ardyrobot/3d-print-ring-camera/docs/sketch.webp

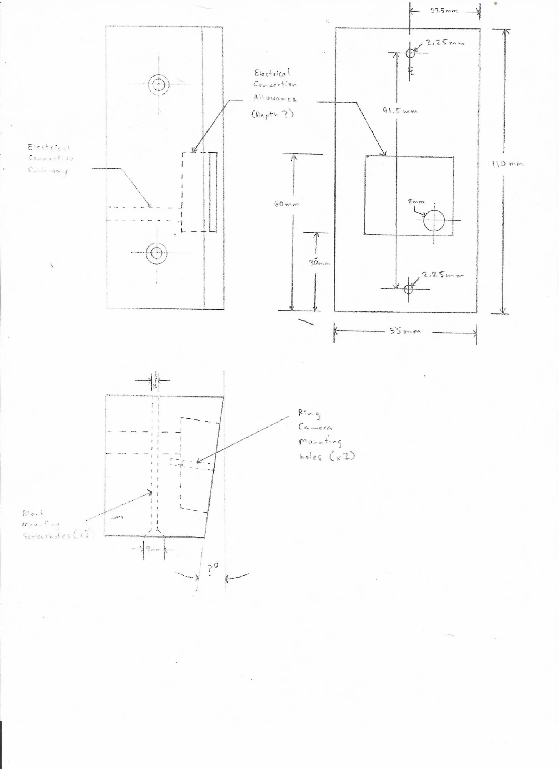
docs/sketch.webp
