ardyrobot/3d-print-ring-camera/option1-solid/docs/block-bottom.png

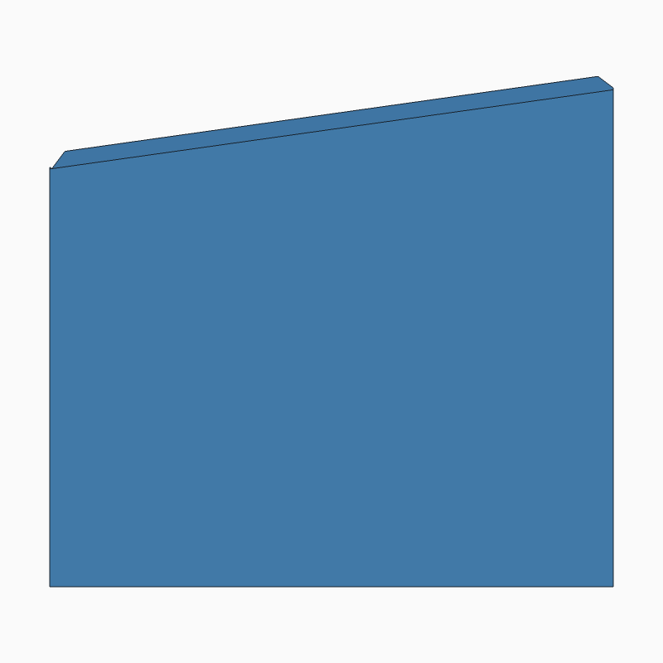
option1-solid/docs/block-bottom.png
