ardyrobot/3d-print-ring-camera/option4-pivot/stl/assembly_3.stl

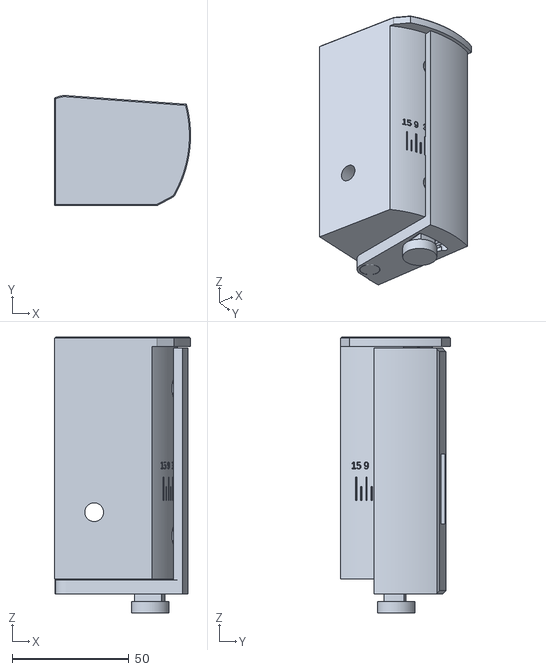
[picture p18: CAD file, 2026-11-03]
option4-pivot/stl/assembly_3.stl
58.3 x 47.2 x 118.1
