ardyrobot/3d-print-ring-camera/option2-hinge/stl/assembly_15.stl

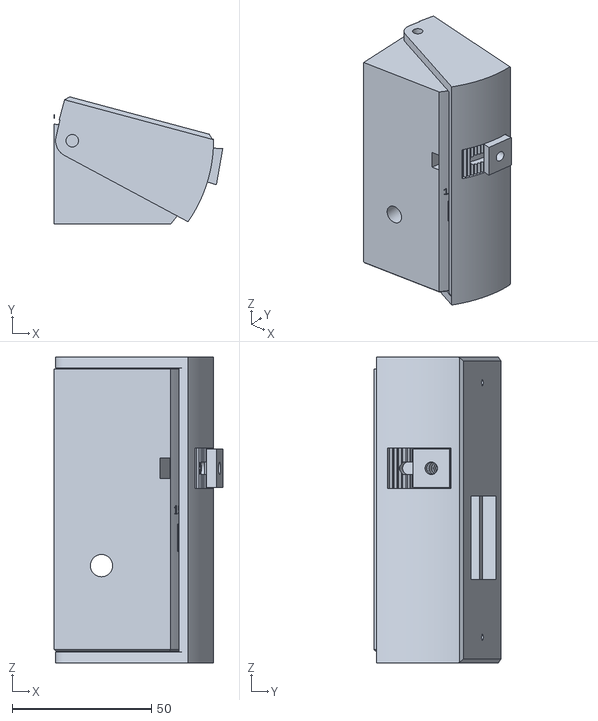
[picture p19: CAD file, 2026-11-03]
option2-hinge/stl/assembly_15.stl
60.6 x 45.8 x 110.0
