ardyrobot/3d-print-ring-camera/option2-hinge/stl/assembly_3.stl

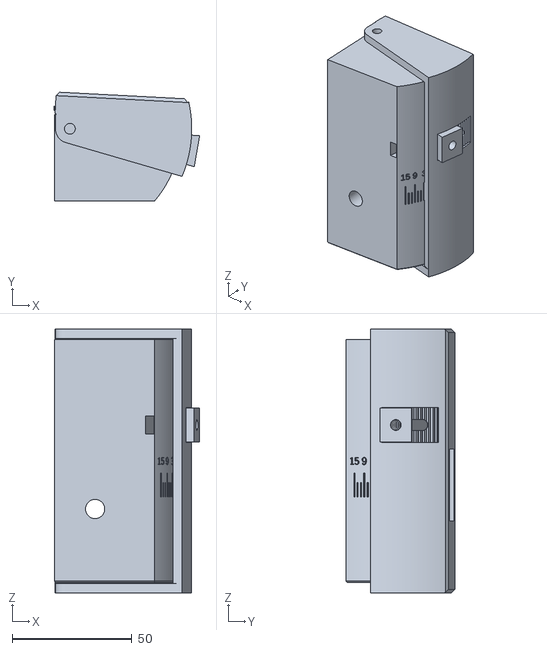
[picture p20: CAD file, 2026-11-03]
option2-hinge/stl/assembly_3.stl
60.6 x 45.2 x 110.0
