ardyrobot/3d-print-ring-camera/option3-dovetail/stl/assembly_3.stl

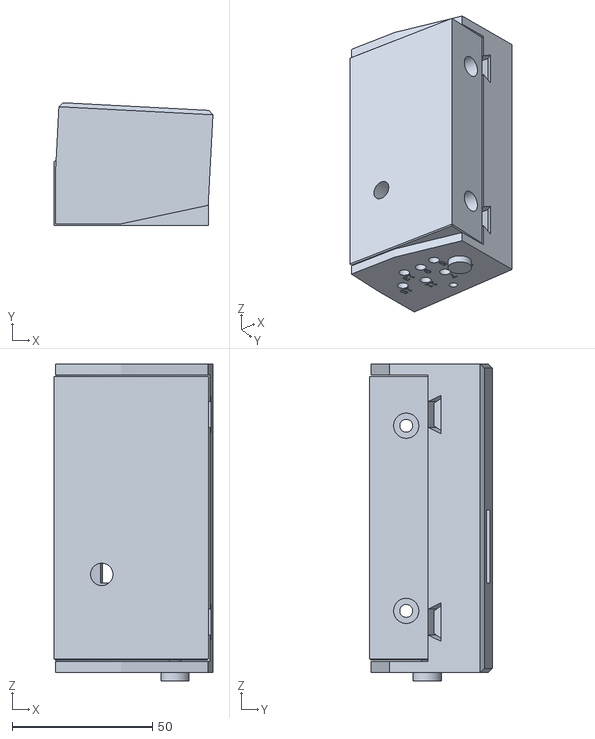
[picture p21: CAD file, 2026-11-02]
option3-dovetail/stl/assembly_3.stl
56.6 x 43.7 x 113.0
