ardyrobot/3d-print-ring-camera/option3-dovetail/stl/assembly_15.stl

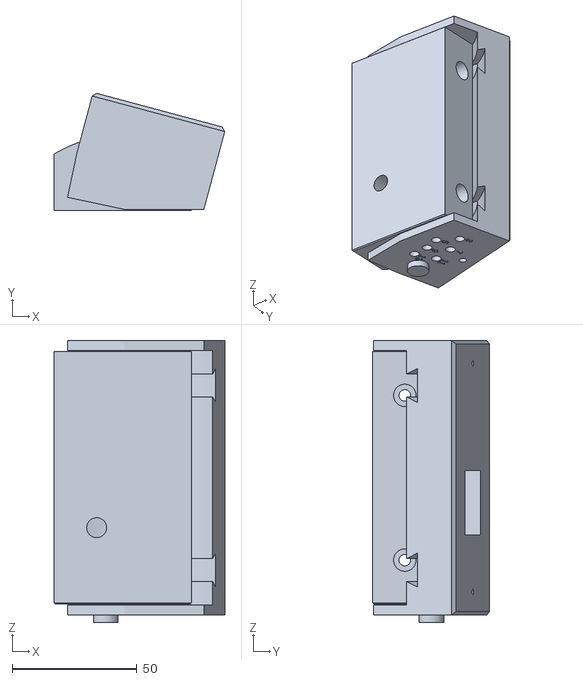
[picture p22: CAD file, 2026-11-02]
option3-dovetail/stl/assembly_15.stl
68.3 x 47.0 x 113.0
