ardyrobot/3d-print-ring-camera/option1-solid/stl/block.stl

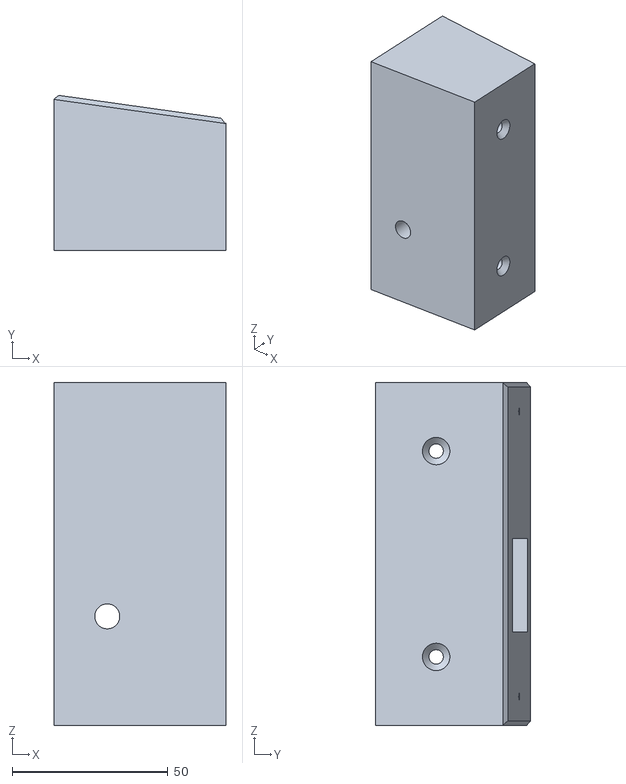
[picture p23: CAD file, 2026-11-03]
option1-solid/stl/block.stl
55.0 x 49.8 x 110.0
