ardyrobot/3d-print-ring-camera/option2-hinge/stl/shell.stl

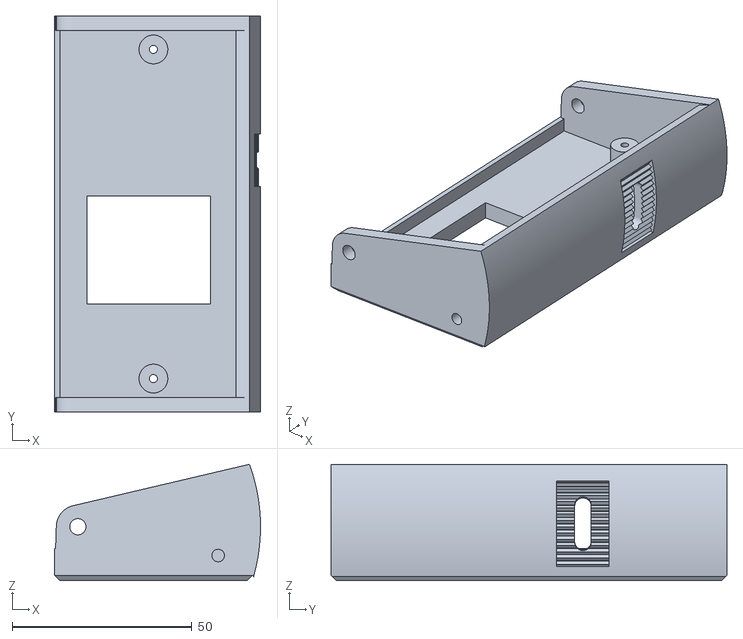
[picture p24: CAD file, 2026-11-03]
option2-hinge/stl/shell.stl
57.3 x 110.0 x 32.4
