ardyrobot/3d-print-ring-camera/option3-dovetail/stl/base.stl

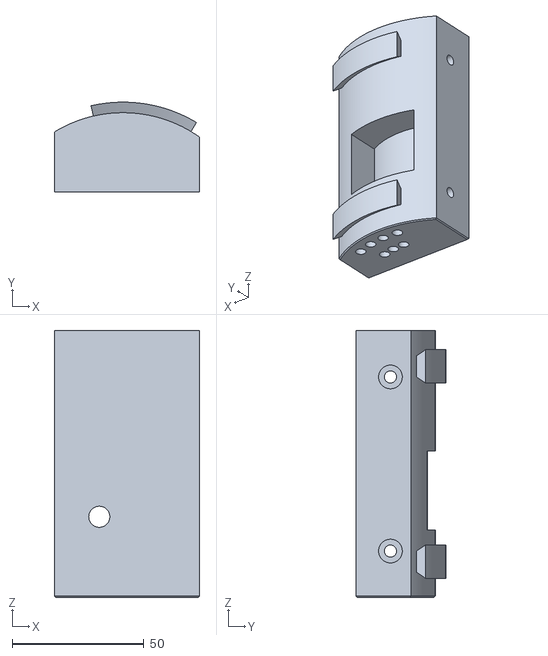
[picture p25: CAD file, 2026-11-02]
option3-dovetail/stl/base.stl
55.0 x 34.0 x 101.2
