ardyrobot/3d-print-ring-camera/option3-dovetail/stl/fit_test.stl

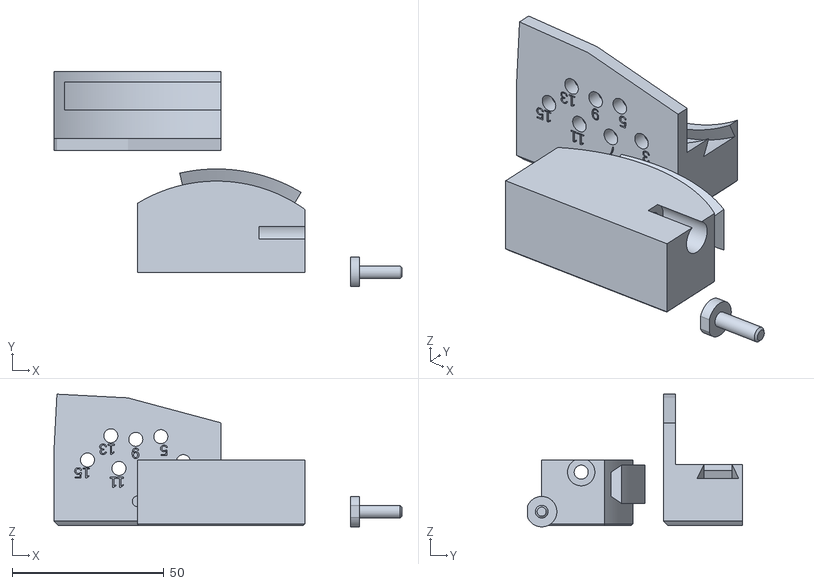
[picture p26: CAD file, 2026-11-02]
option3-dovetail/stl/fit_test.stl
114.5 x 70.6 x 43.7
