ardyrobot/3d-print-ring-camera/option4-pivot/stl/shell.stl

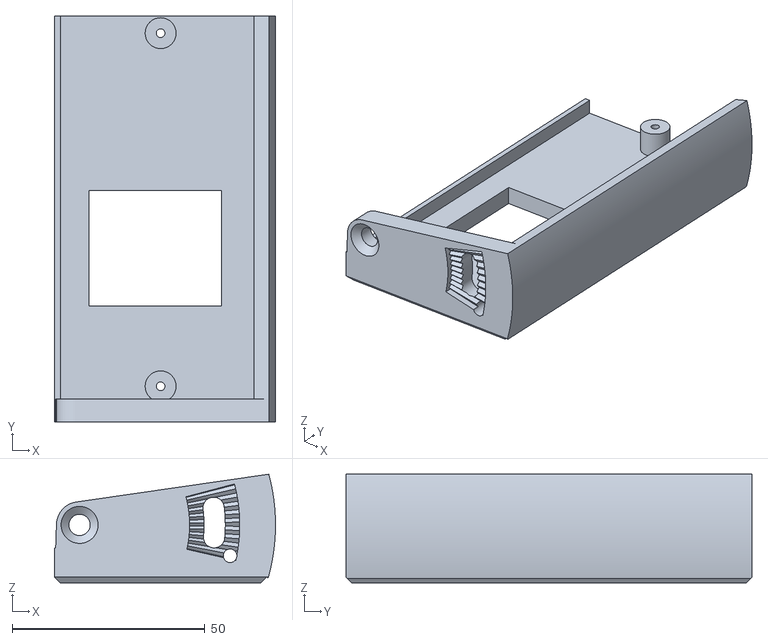
[picture p27: CAD file, 2026-11-03]
option4-pivot/stl/shell.stl
57.3 x 105.2 x 28.1
