ardyrobot/3d-print-ring-camera/option2-hinge/stl/fit_test.stl

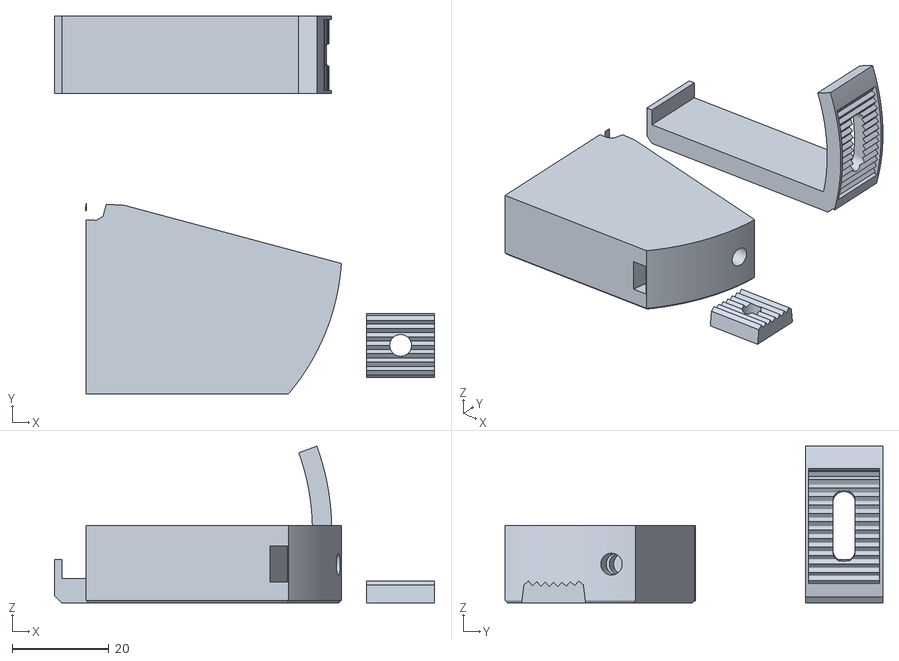
[picture p28: CAD file, 2026-11-03]
option2-hinge/stl/fit_test.stl
78.5 x 78.0 x 32.4
