ardyrobot/3d-print-ring-camera/option4-pivot/stl/base.stl

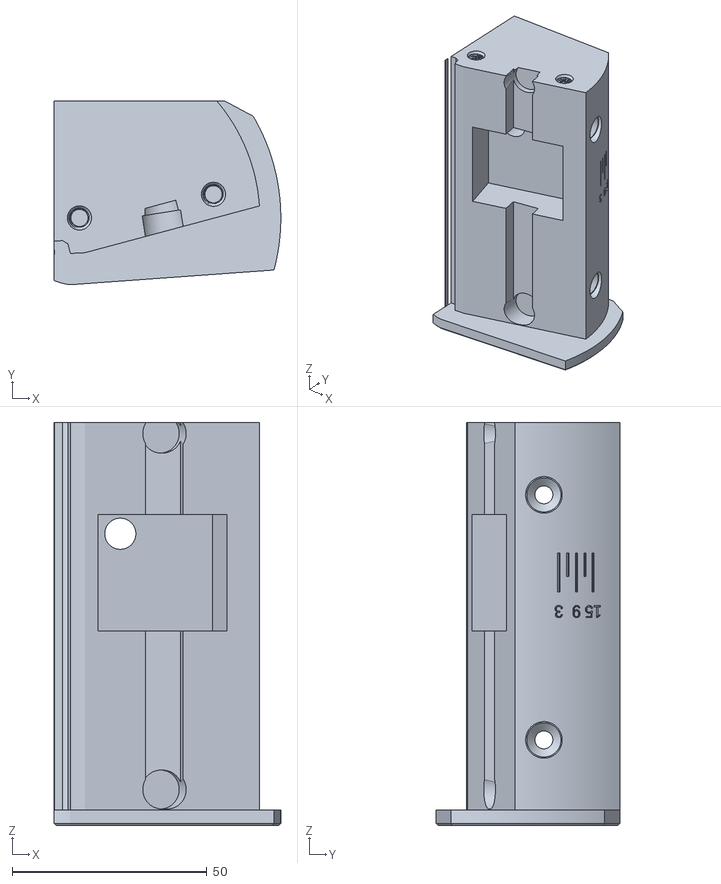
[picture p29: CAD file, 2026-11-03]
option4-pivot/stl/base.stl
58.3 x 47.2 x 103.6
