ardyrobot/3d-print-ring-camera/option2-hinge/stl/base.stl

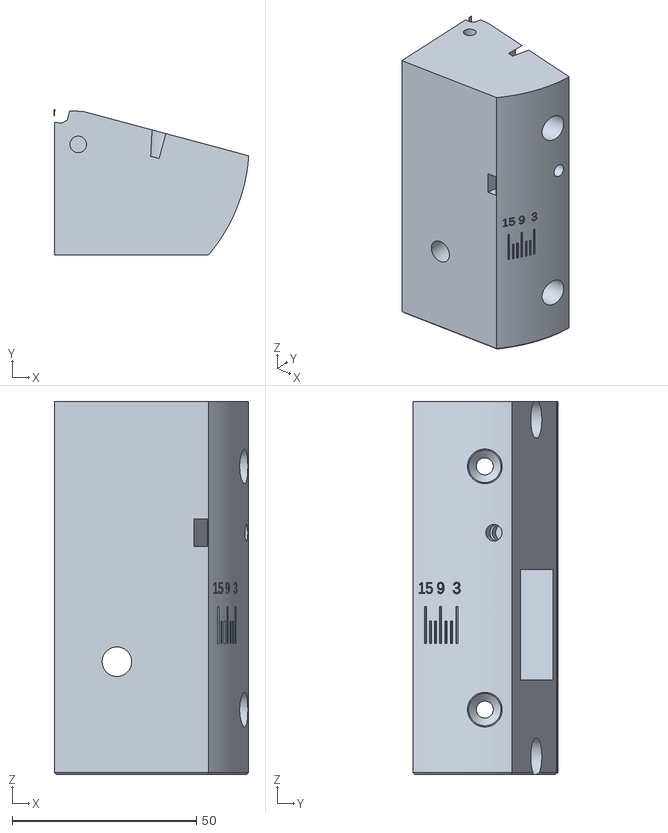
[picture p30: CAD file, 2026-11-03]
option2-hinge/stl/base.stl
52.8 x 39.4 x 101.2
