ardyrobot/3d-print-ring-camera/option3-dovetail/stl/pin.stl

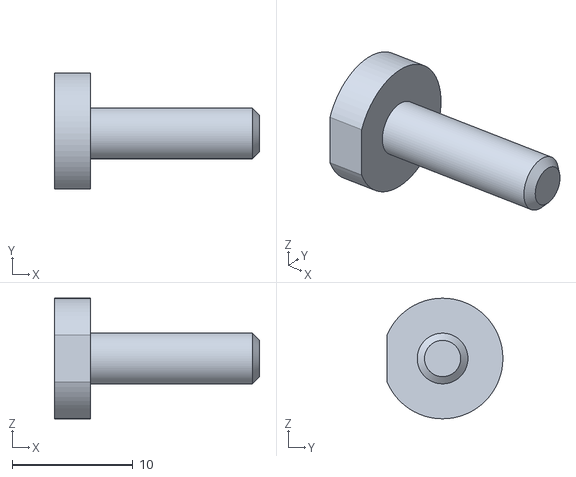
[picture p31: CAD file, 2026-11-02]
option3-dovetail/stl/pin.stl
17.0 x 9.60 x 10.0
