ardyrobot/3d-print-ring-camera/option4-pivot/stl/fit_test.stl

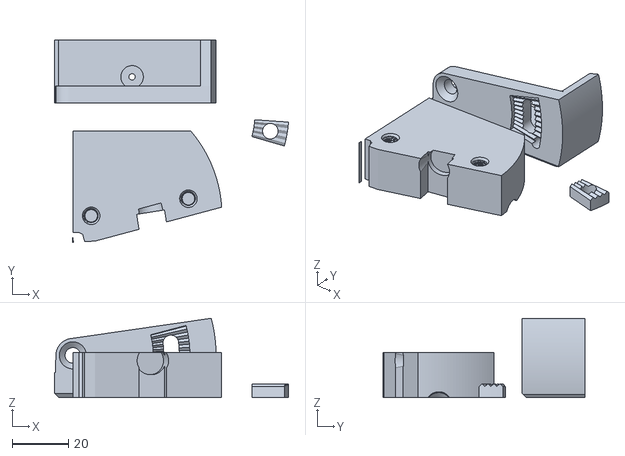
[picture p32: CAD file, 2026-11-03]
option4-pivot/stl/fit_test.stl
82.9 x 71.8 x 28.1
