ardyrobot/3d-print-ring-camera/option3-dovetail/stl/shell.stl

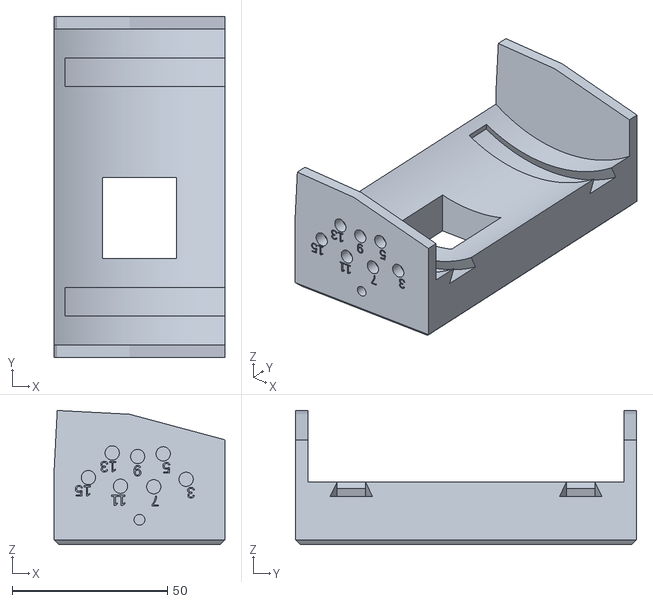
[picture p33: CAD file, 2026-11-02]
option3-dovetail/stl/shell.stl
55.0 x 110.0 x 43.3
