ardyrobot/3d-print-ring-camera/option2-hinge/stl/washer.stl

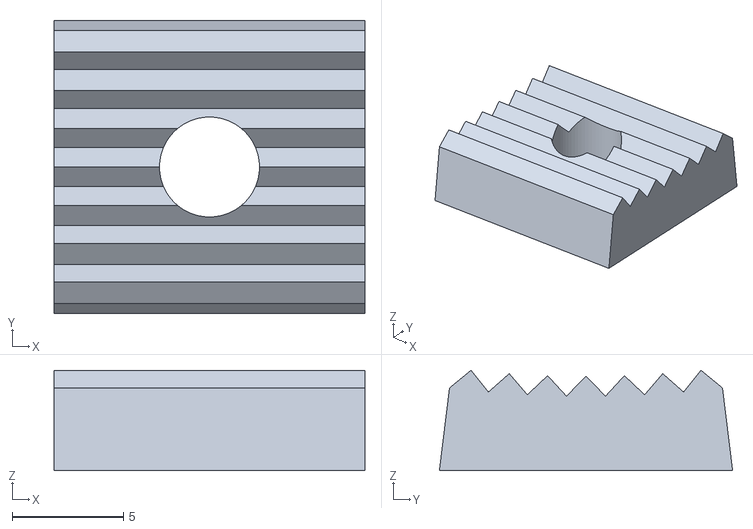
[picture p34: CAD file, 2026-11-01]
option2-hinge/stl/washer.stl
14.0 x 13.2 x 4.52
