ardyrobot/3d-print-ring-camera/option3-dovetail/prints/pin.scad

// Print file: option 3 (dovetail slide), the lock pin.
// build.ps1 exports ../stl/pin.stl from this file. Print orientation: Lying on its small flat.
//
// To change this one print: uncomment a setting below (or add any value from
// ../option3_dovetail.scad), then in OpenSCAD press F6 and use File > Export > STL.
// The last value set wins, so a setting here only affects this print.
//   - Fixed measurements (mount_common.scad) can't be changed here: the build fails.
//   - Print tolerances that two parts share must match, so change those in
//     ../option3_dovetail.scad instead. The build warns if one is set here.

include <../option3_dovetail.scad>

part = "pin";

// Settings for this print:
// (none specific to this part)
