ardyrobot/3d-print-ring-camera/(list of files, cad)

Other CAD files:
option4-pivot/stl/assembly_15.stl
option2-hinge/prints/base.scad
option2-hinge/prints/shell.scad
option2-hinge/prints/washer.scad
option3-dovetail/prints/base.scad
option3-dovetail/prints/shell.scad
option4-pivot/prints/base.scad
option4-pivot/prints/shell.scad
option4-pivot/prints/washer.scad
option2-hinge/prints/fit_test.scad
option3-dovetail/prints/fit_test.scad
option4-pivot/prints/fit_test.scad
option4-pivot/stl/washer.stl
