ardyrobot/3d-print-ring-camera/option3-dovetail/docs/assembly-15-under.png

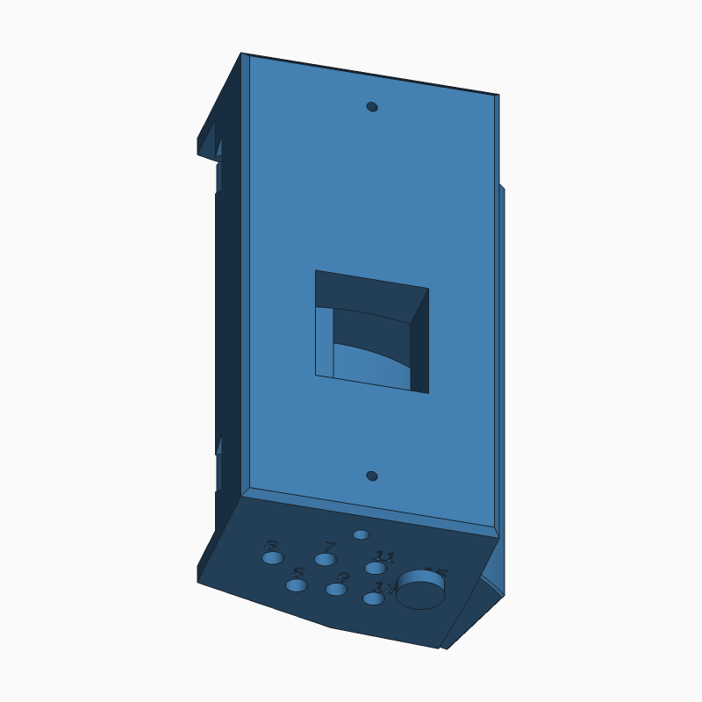
option3-dovetail/docs/assembly-15-under.png
