ardyrobot/3d-print-ring-camera/docs/MEASUREMENTS.md

# Measurements

<!-- GENERATED by tools/param_table.py during build.ps1. Do not edit by hand:
     change the value in the .scad file and rebuild. -->

Generated from the model files on every build, so it always matches what
was printed. **To change a value, edit it in the `.scad` file and run
`build.ps1`**; never edit this file.

Lengths in mm, angles in degrees. Source key: **written** = on the hand
sketch (`written?` = hard to read) · **scaled** = measured off the sketch,
about ±1 mm · **fixed** = set by Cat · **chosen** = design decision ·
**tolerance** = print clearance, tune with the fit test.

The fixed measurements (envelope, Ring holes, pocket, cable hole, mounting
screws) come from [`mount_common.scad`](../mount_common.scad) and are the
same in every option; the build fails if a model redefines one.

Axes: X = width (0 = deep side, against the mounting surface) · Y = depth
(0 = back face, cable entry) · Z = height (0 = bottom).

## Option 1: solid block (primary)

Source file: [`option1-solid/option1_solid.scad`](../option1-solid/option1_solid.scad)

### Built size (from the exported STLs)

| Part | X × Y × Z (mm) | Volume (cm³) | Watertight |
|---|---|---|---|
| [Block](../option1-solid/stl/block.stl) | 55.00 × 49.79 × 110.00 | 254.73 | yes |

### Envelope

| Parameter | Value | Source | Notes |
|---|---|---|---|
| `width` | 55 | written | block width / camera face width |
| `height` | 110 | written |  |

### Ring mounting holes

| Parameter | Value | Source | Notes |
|---|---|---|---|
| `ring_hole_d` | 2.25 | written | pilot for the Ring bracket screws |
| `ring_hole_spacing` | 91.5 | written | centre to centre, vertically centred |
| `ring_hole_depth` | 12 | chosen | measured into the camera face |

### Wiring pocket

| Parameter | Value | Source | Notes |
|---|---|---|---|
| `pocket_z_min` | 30 | written | bottom of pocket above block bottom |
| `pocket_z_max` | 60 | written | top of pocket above block bottom |
| `pocket_deep_inset` | 9 | scaled | pocket edge to deep side, front view |
| `pocket_width` | 34.3 | scaled | front-view width |
| `pocket_depth` | 15 | fixed | behind the camera plate (options 2-4; option 1 uses its own block_pocket_depth, 20) |

### Cable hole

| Parameter | Value | Source | Notes |
|---|---|---|---|
| `cable_d` | 8 | written |  |
| `cable_z` | 35 | scaled | centre height |
| `cable_deep_inset` | 17 | scaled | centre to deep side (where the wire leaves the wall) |

### Mounting screws

| Parameter | Value | Source | Notes |
|---|---|---|---|
| `screw_d` | 4.6 | fixed | clearance for #8 (4.17 mm shank) so it pulls the mount tight |
| `screw_head_d` | 8.8 | fixed | countersink diameter for the #8 head (8.43 mm max) |
| `screw_sink_angle` | 82 | fixed | US flat-head angle (metric is 90) |

### Block

| Parameter | Value | Source | Notes |
|---|---|---|---|
| `depth_deep` | 50 | chosen | depth at the deep (mounting) side (46 scaled off the sketch; Cat 2026-11-02: 50, more room behind the pocket) |
| `face_angle` | 8 | chosen | degrees the camera face is turned |
| `face_chamfer` | 1.5 | chosen | 45 degree bevel on the camera-face edges; 0 = none |

### Pocket

| Parameter | Value | Source | Notes |
|---|---|---|---|
| `block_pocket_depth` | 17 | chosen | shallowest depth behind the camera face |

### Cable hole flare

| Parameter | Value | Source | Notes |
|---|---|---|---|
| `cable_flare_d` | 15 | chosen | mouth diameter at the pocket's back wall |
| `cable_flare_floor` | pocket_z_min | chosen | height the funnel is trimmed flat at (the pocket floor) |
| `cable_mouth_chamfer` | 1.5 | chosen | 45 degree chamfer on the funnel's rim at the pocket wall, so no sharp edge; 0 = none |
| `cable_flare_len` | 8 | chosen | length of the funnel along the hole; longer = gentler bend |

### Checks

| Parameter | Value | Source | Notes |
|---|---|---|---|
| `min_screw_wall` | 4 | chosen | plastic required between a screw hole and the pocket or flare |

### Block mounting screws

| Parameter | Value | Source | Notes |
|---|---|---|---|
| `screw_y` | 19.5 | scaled | distance from back face. The sketch centred it on the shallow side (19.1 at the old 46 depth); kept at 19.5 when the block went to 50 (Cat 2026-11-02) for ~7 mm of plastic below the pocket |
| `screw_z` | [22, 88] | scaled | heights (kept, Cat 2026-11-02: lower would put the head bevel near the edge) |
| `screw_head_recess` | 0 | chosen | extra counterbore depth to shorten screws |

## Option 2: adjustable hinge

Source file: [`option2-hinge/option2_hinge.scad`](../option2-hinge/option2_hinge.scad)

### Built size (from the exported STLs)

| Part | X × Y × Z (mm) | Volume (cm³) | Watertight |
|---|---|---|---|
| [Base](../option2-hinge/stl/base.stl) | 52.76 × 39.35 × 101.20 | 147.69 | yes |
| [Shell](../option2-hinge/stl/shell.stl) | 57.27 × 110.00 × 32.36 | 46.17 | yes |
| [Washer](../option2-hinge/stl/washer.stl) | 14.00 × 13.20 × 4.52 | 0.64 | yes |
| [Fit test (3 pieces, as laid out)](../option2-hinge/stl/fit_test.stl) | 78.50 × 78.00 × 32.36 | 32.15 | yes |

### Envelope

| Parameter | Value | Source | Notes |
|---|---|---|---|
| `width` | 55 | written | block width / camera face width |
| `height` | 110 | written |  |

### Ring mounting holes

| Parameter | Value | Source | Notes |
|---|---|---|---|
| `ring_hole_d` | 2.25 | written | pilot for the Ring bracket screws |
| `ring_hole_spacing` | 91.5 | written | centre to centre, vertically centred |
| `ring_hole_depth` | 12 | chosen | measured into the camera face |

### Wiring pocket

| Parameter | Value | Source | Notes |
|---|---|---|---|
| `pocket_z_min` | 30 | written | bottom of pocket above block bottom |
| `pocket_z_max` | 60 | written | top of pocket above block bottom |
| `pocket_deep_inset` | 9 | scaled | pocket edge to deep side, front view |
| `pocket_width` | 34.3 | scaled | front-view width |
| `pocket_depth` | 15 | fixed | behind the camera plate (options 2-4; option 1 uses its own block_pocket_depth, 20) |

### Cable hole

| Parameter | Value | Source | Notes |
|---|---|---|---|
| `cable_d` | 8 | written |  |
| `cable_z` | 35 | scaled | centre height |
| `cable_deep_inset` | 17 | scaled | centre to deep side (where the wire leaves the wall) |

### Mounting screws

| Parameter | Value | Source | Notes |
|---|---|---|---|
| `screw_d` | 4.6 | fixed | clearance for #8 (4.17 mm shank) so it pulls the mount tight |
| `screw_head_d` | 8.8 | fixed | countersink diameter for the #8 head (8.43 mm max) |
| `screw_sink_angle` | 82 | fixed | US flat-head angle (metric is 90) |

### Print tolerances

| Parameter | Value | Source | Notes |
|---|---|---|---|
| `gap` | 0.4 | tolerance | sliding gap: skirt over base, top/bottom plates over base |
| `tooth_clr` | 0.25 | tolerance | washer teeth clearance (tips and roots) |
| `bolt_d` | 4.5 | tolerance | M4 clearance hole |
| `nut_af` | 7.4 | tolerance | M4 nut across flats (7.0) + clearance |
| `nut_t` | 3.6 | tolerance | M4 nut thickness (3.2) + clearance |
| `washer_side` | 0.3 | tolerance | washer to track walls, each side |
| `swing_clr` | 1.0 | tolerance | camera plate and Ring bosses to base, through the swing |
| `foot_chamfer` | 0.5 | tolerance | base bottom edge, absorbs first-layer squash (elephant's foot) |

### Angle range

| Parameter | Value | Source | Notes |
|---|---|---|---|
| `angle_min` | 3 | chosen |  |
| `angle_max` | 15 | chosen |  |
| `angle_step` | 2 | chosen | one tooth |

### Shell

| Parameter | Value | Source | Notes |
|---|---|---|---|
| `wall` | 4 | chosen | skirt and top/bottom plate thickness |
| `face_t` | 5 | chosen | camera plate thickness |
| `face_back` | 10 | chosen | hinge axis to back of camera plate |
| `face_chamfer` | 1.5 | chosen | matches the solid block |
| `skirt_end` | -20 | chosen | trailing edge angle of the skirt, shell frame |
| `boss_d` | 8 | chosen | bosses behind the Ring holes |
| `drain_d` | 3.5 | chosen | drain hole in the bottom plate |
| `deep_lip_t` | 1.5 | chosen | lip thickness |
| `deep_lip_len` | 4 | chosen | how far the lip reaches back from the plate's back face |

### Hinge

| Parameter | Value | Source | Notes |
|---|---|---|---|
| `hinge_x` | 6.5 | chosen | axis distance from the mounting surface |
| `hinge_y` | 30 | chosen | axis distance from the back face |
| `hinge_nut_in` | 8 | chosen | nut depth below base top/bottom |

### Clamp and teeth

| Parameter | Value | Source | Notes |
|---|---|---|---|
| `clamp_angle` | -10 | chosen | clamp bolt direction, base frame |
| `clamp_z` | 70 | chosen |  |
| `clamp_nut_r` | 38 | chosen | nut distance from hinge axis |
| `track_depth` | 1.5 | chosen | recess in the skirt for the washer |
| `tooth_h` | 0.9 | chosen | 2 deg pitch is ~1.7 mm at this radius |
| `washer_half` | 7 | chosen | washer half-width, degrees (odd) |
| `washer_h` | 14 | chosen |  |
| `washer_t` | 3 | chosen | washer thickness beyond the skirt surface |

### Base

| Parameter | Value | Source | Notes |
|---|---|---|---|
| `screw_y` | 19.5 | scaled | distance from back face (position not fixed; size is shared) |
| `screw_z` | [22, 88] | scaled | heights |
| `screw_cbore_d` | 9.4 | chosen | counterbore so heads sit under the skirt (#8 head 8.43 mm + clearance) |
| `screw_seat_x` | 40 | chosen | screw head seat; screw length = this + embedment |

### Scale

| Parameter | Value | Source | Notes |
|---|---|---|---|
| `label_angles` | [3, 9, 15] | chosen | numbered ticks |
| `text_size` | 3.2 | chosen | label height |
| `engrave` | 0.6 | chosen | engraving depth |

## Option 3: dovetail slide

Source file: [`option3-dovetail/option3_dovetail.scad`](../option3-dovetail/option3_dovetail.scad)

### Built size (from the exported STLs)

| Part | X × Y × Z (mm) | Volume (cm³) | Watertight |
|---|---|---|---|
| [Base](../option3-dovetail/stl/base.stl) | 55.00 × 34.00 × 101.20 | 134.87 | yes |
| [Shell](../option3-dovetail/stl/shell.stl) | 55.00 × 110.00 × 43.26 | 85.92 | yes |
| [Pin](../option3-dovetail/stl/pin.stl) | 16.99 × 9.60 × 10.00 | 0.42 | yes |
| [Fit test (3 pieces, as laid out)](../option3-dovetail/stl/fit_test.stl) | 114.49 × 70.60 × 43.66 | 55.18 | yes |

### Envelope

| Parameter | Value | Source | Notes |
|---|---|---|---|
| `width` | 55 | written | block width / camera face width |
| `height` | 110 | written |  |

### Ring mounting holes

| Parameter | Value | Source | Notes |
|---|---|---|---|
| `ring_hole_d` | 2.25 | written | pilot for the Ring bracket screws |
| `ring_hole_spacing` | 91.5 | written | centre to centre, vertically centred |
| `ring_hole_depth` | 12 | chosen | measured into the camera face |

### Wiring pocket

| Parameter | Value | Source | Notes |
|---|---|---|---|
| `pocket_z_min` | 30 | written | bottom of pocket above block bottom |
| `pocket_z_max` | 60 | written | top of pocket above block bottom |
| `pocket_deep_inset` | 9 | scaled | pocket edge to deep side, front view |
| `pocket_width` | 34.3 | scaled | front-view width |
| `pocket_depth` | 15 | fixed | behind the camera plate (options 2-4; option 1 uses its own block_pocket_depth, 20) |

### Cable hole

| Parameter | Value | Source | Notes |
|---|---|---|---|
| `cable_d` | 8 | written |  |
| `cable_z` | 35 | scaled | centre height |
| `cable_deep_inset` | 17 | scaled | centre to deep side (where the wire leaves the wall) |

### Mounting screws

| Parameter | Value | Source | Notes |
|---|---|---|---|
| `screw_d` | 4.6 | fixed | clearance for #8 (4.17 mm shank) so it pulls the mount tight |
| `screw_head_d` | 8.8 | fixed | countersink diameter for the #8 head (8.43 mm max) |
| `screw_sink_angle` | 82 | fixed | US flat-head angle (metric is 90) |

### Print tolerances

| Parameter | Value | Source | Notes |
|---|---|---|---|
| `gap` | 0.4 | tolerance | shell back to base front |
| `dove_clr` | 0.3 | tolerance | dovetail rail in groove, every face |
| `pin_free` | 0.4 | tolerance | pin in the shell hole (slides freely) |
| `pin_snug` | -0.1 | tolerance | pin in the bottom of the base hole (slight grip) |
| `swing_clr` | 0.5 | tolerance | shell and hoods to the frame and wall, at the range ends |
| `foot_chamfer` | 0.5 | tolerance | base bottom edge |

### Angle range

| Parameter | Value | Source | Notes |
|---|---|---|---|
| `angle_min` | 3 | chosen |  |
| `angle_max` | 15 | chosen |  |
| `angle_step` | 2 | chosen |  |

### Virtual pivot and arc

| Parameter | Value | Source | Notes |
|---|---|---|---|
| `pivot_x` | 26 | chosen | pivot position (behind the wall, so y < 0) |
| `pivot_y` | -20 | chosen |  |
| `arc_r` | 50 | chosen | base front radius around the pivot |
| `rail_half` | 22 | chosen | rails span arc_mid +/- this many degrees |

### Shell

| Parameter | Value | Source | Notes |
|---|---|---|---|
| `face_y` | 62.4 | chosen | camera face, shell frame (12 mm in front of the shell back) |
| `wall` | 4 | chosen | hood thickness |
| `face_chamfer` | 1.5 | chosen | matches the other options |
| `window_half` | 12 | chosen | wire window half-width |
| `drain_d` | 3.5 | chosen |  |

### Dovetails

| Parameter | Value | Source | Notes |
|---|---|---|---|
| `rail_z` | [18, 92] | chosen | rail centre heights |
| `rail_root` | 8 | chosen | rail width where it meets the base |
| `rail_h` | 4 | chosen | rail height |
| `dove_angle` | 30 | chosen | flank angle from radial; 30 = prints without supports |

### Lock pin

| Parameter | Value | Source | Notes |
|---|---|---|---|
| `pin_d` | 4.2 | chosen |  |
| `pin_len` | 14 | chosen | shank length |
| `pin_head_d` | 10 | chosen |  |
| `pin_head_t` | 3 | chosen |  |
| `pin_depth` | 10 | chosen | depth into the base |
| `pin_rows` | [[44, 20, [3, 7, 11, 15]], [34, 13, [5, 9, 13]]] | chosen | [radius, first shell angle, angles] |
| `pin_step` | -14 | chosen | shell angle between holes in a row |
| `label_size` | 3.5 | chosen |  |
| `engrave` | 0.6 | chosen |  |

### Base

| Parameter | Value | Source | Notes |
|---|---|---|---|
| `screw_cbore_d` | 9 | chosen |  |
| `screw_seat_x` | 40 | chosen | head seat; driven in from the open side |
| `screw_y` | 13 | chosen | lower than the sketch's 19.5 so the heads sit below the shell's path (positions aren't fixed); 13 leaves 8.5 mm behind the counterbore |
| `screw_z` | [22, 88] | scaled | heights |

## Option 4: pivot with roof

Source file: [`option4-pivot/option4_pivot.scad`](../option4-pivot/option4_pivot.scad)

### Built size (from the exported STLs)

| Part | X × Y × Z (mm) | Volume (cm³) | Watertight |
|---|---|---|---|
| [Base (with roof)](../option4-pivot/stl/base.stl) | 58.27 × 47.18 × 103.60 | 154.94 | yes |
| [Shell](../option4-pivot/stl/shell.stl) | 57.27 × 105.20 × 28.14 | 39.63 | yes |
| [Washer](../option4-pivot/stl/washer.stl) | 13.02 × 9.28 × 4.90 | 0.29 | yes |
| [Fit test (3 pieces, as laid out)](../option4-pivot/stl/fit_test.stl) | 82.93 × 71.75 × 28.14 | 39.19 | yes |

### Envelope

| Parameter | Value | Source | Notes |
|---|---|---|---|
| `width` | 55 | written | block width / camera face width |
| `height` | 110 | written |  |

### Ring mounting holes

| Parameter | Value | Source | Notes |
|---|---|---|---|
| `ring_hole_d` | 2.25 | written | pilot for the Ring bracket screws |
| `ring_hole_spacing` | 91.5 | written | centre to centre, vertically centred |
| `ring_hole_depth` | 12 | chosen | measured into the camera face |

### Wiring pocket

| Parameter | Value | Source | Notes |
|---|---|---|---|
| `pocket_z_min` | 30 | written | bottom of pocket above block bottom |
| `pocket_z_max` | 60 | written | top of pocket above block bottom |
| `pocket_deep_inset` | 9 | scaled | pocket edge to deep side, front view |
| `pocket_width` | 34.3 | scaled | front-view width |
| `pocket_depth` | 15 | fixed | behind the camera plate (options 2-4; option 1 uses its own block_pocket_depth, 20) |

### Cable hole

| Parameter | Value | Source | Notes |
|---|---|---|---|
| `cable_d` | 8 | written |  |
| `cable_z` | 35 | scaled | centre height |
| `cable_deep_inset` | 17 | scaled | centre to deep side (where the wire leaves the wall) |

### Mounting screws

| Parameter | Value | Source | Notes |
|---|---|---|---|
| `screw_d` | 4.6 | fixed | clearance for #8 (4.17 mm shank) so it pulls the mount tight |
| `screw_head_d` | 8.8 | fixed | countersink diameter for the #8 head (8.43 mm max) |
| `screw_sink_angle` | 82 | fixed | US flat-head angle (metric is 90) |

### Print tolerances

| Parameter | Value | Source | Notes |
|---|---|---|---|
| `gap` | 0.4 | tolerance | sliding gap: skirt over base, bottom plate under base |
| `roof_clr` | 0.8 | tolerance | shell top to roof underside (0.4 left once the screws pull the plate up) |
| `tooth_clr` | 0.25 | tolerance | washer teeth clearance (tips and roots) |
| `track_clr` | 0.5 | tolerance | washer to track walls, each side |
| `thread_clr` | 0.3 | tolerance | added to the M5 thread diameters in the base |
| `screw_clr_d` | 5.5 | tolerance | M5 clearance hole / slot width in the shell and washer |
| `swing_clr` | 1.0 | tolerance | camera plate and Ring bosses to base, through the swing |
| `foot_chamfer` | 0.5 | tolerance | first-layer edge chamfer (elephant's foot) |

### Angle range

| Parameter | Value | Source | Notes |
|---|---|---|---|
| `angle_min` | 3 | chosen |  |
| `angle_max` | 15 | chosen |  |
| `angle_step` | 3 | chosen | one tooth |
| `install_angle` | 9 | chosen | angle the shell slides up at (boss channel) |

### Shell

| Parameter | Value | Source | Notes |
|---|---|---|---|
| `wall` | 4 | chosen | skirt thickness |
| `plate_t` | 6 | chosen | bottom plate thickness |
| `face_t` | 5 | chosen | camera plate thickness |
| `face_back` | 10 | chosen | hinge axis to back of camera plate |
| `face_chamfer` | 1.5 | chosen | matches the solid block |
| `skirt_end` | -15 | chosen | trailing edge angle of the skirt, shell frame (4.6 mm off the wall at 15) |
| `boss_d` | 8 | chosen | bosses behind the Ring holes |
| `drain_d` | 3.5 | chosen | drain hole in the bottom plate |
| `deep_lip_t` | 1.5 | chosen | lip thickness |
| `deep_lip_len` | 4 | chosen | how far the lip reaches back from the plate's back face |

### Base and roof

| Parameter | Value | Source | Notes |
|---|---|---|---|
| `roof_t` | 4 | chosen |  |
| `roof_overhang` | 1 | chosen | how far the roof reaches past the shell at its outermost, all round |
| `hinge_x` | 6.5 | chosen | pivot axis distance from the mounting surface |
| `hinge_y` | 30 | chosen | pivot axis distance from the back face |
| `screw_y` | 19.5 | scaled | distance from back face (position not fixed; size is shared) |
| `screw_z` | [25, 88] | chosen | heights; 25 (not 22) keeps 4 mm of plastic above the lock thread |
| `screw_seat_x` | 49 | chosen | screw head seat; screw length = this + embedment (~75 mm, 3 in) |
| `screw_cbore_d` | 9.4 | chosen | counterbore so heads sit under the skirt |

### Lock

| Parameter | Value | Source | Notes |
|---|---|---|---|
| `lock_r` | 35 | chosen | lock screw distance from the pivot axis |
| `lock_a` | -10 | chosen | lock screw direction from the pivot, base frame |
| `tooth_h` | 0.9 | chosen | 3 deg pitch is 1.83 mm at lock_r |
| `track_d` | 2 | chosen | washer track recessed into the plate underside |
| `washer_half` | 6 | chosen | washer half-width, degrees (4 teeth) |
| `washer_band` | 6 | chosen | washer half-width, radial |
| `washer_t` | 4 | chosen | washer body thickness below the teeth |

### Threads

| Parameter | Value | Source | Notes |
|---|---|---|---|
| `thread_p` | 0.8 | chosen | M5 coarse pitch |
| `pivot_thread_l` | 15 | chosen | thread depth into the base (M5 x 20 screw engages ~13.6) |
| `lock_thread_l` | 12 | chosen | thread depth into the base (M5 x 20 screw engages ~10.4) |
| `pivot_head_d` | 9.2 | chosen | M5 countersunk slotted screw head (ISO 2009), 90 degrees, flush in the plate (Cat 2026-11-02) |
| `pivot_sink_clr` | 0.4 | chosen | countersink oversize so the head can sit flush |
| `lock_head_d` | 16 | chosen | M5 knurled thumb screw head, typical (check the one you buy) |

### Scale

| Parameter | Value | Source | Notes |
|---|---|---|---|
| `label_angles` | [3, 9, 15] | chosen | numbered ticks |
| `text_size` | 3.2 | chosen | label height |
| `engrave` | 0.6 | chosen | engraving depth |
