ardyrobot/3d-print-ring-camera/(commit log)

2026-11-01 Add parametric Ring camera mount model
    OpenSCAD source with every dimension tagged written/scaled/chosen against the hand sketch, a build script that exports the STL and preview PNGs, and stdlib-only Python tools to check the STL and render previews. Build check: 55.00 x 46.00 x 110.00 mm, 236.67 cm3, watertight. Not yet test-printed; open items tracked in README.
    [ring_mount.scad, ring_mount.stl]
2026-11-01 Add face chamfer feature to ring camera mount model
    [ring_mount.scad, ring_mount.stl]
2026-11-01 Add script to generate MEASUREMENTS.md from .scad parameters and STLs
    This commit introduces a new Python script, tools/param_table.py, which extracts parameters from .scad files and generates a markdown file (docs/MEASUREMENTS.md) containing measurements and details about the 3D models. The script reads parameters defined in the .scad files, including those from included files, and organizes them into sections based on the defined structure. It also measures the dimensions and volume of the generated STL files, providing a comprehensive overview of the model specifications.
    [adjustable_assembly_15.stl, adjustable_assembly_3.stl, adjustable_base.stl, adjustable_fit_test.stl, adjustable_shell.stl, adjustable_washer.stl, ring_common.scad, ring_mount.scad]
2026-11-01 Add ring mount slide design and demo packaging script
    - Introduced a new SCAD file `ring_mount_slide.scad` for a camera shell that slides on curved dovetail rails, including detailed comments on functionality and design choices.
    - Added a Python script `pack_demo.py` to package STL files into a single JavaScript file for easier publishing of the demo, encoding the models in base64 format.
    [ring_mount_slide.scad]
2026-11-02 Add shared ring camera interface parameters for mount variants
    [mount_common.scad]
2026-11-02 Refactor code structure for improved readability and maintainability
    [mount_common.scad, ring_mount.scad, ring_mount_adjustable.scad, ring_mount_slide.scad, slide_assembly_15.stl, slide_assembly_3.stl, slide_base.stl, slide_fit_test.stl]
2026-11-02 Update mounting screw specifications and adjust related parameters in SCAD files; enhance documentation for clarity.
    [adjustable_assembly_15.stl, adjustable_assembly_3.stl, adjustable_base.stl, mount_common.scad, ring_mount.scad, ring_mount.stl, ring_mount_adjustable.scad, ring_mount_slide.scad]
2026-11-02 Add video narration and recording functionality
    - Implemented `make_narration.py` to generate WAV files from storyboard narration using Windows' built-in text-to-speech.
    - Created `record_video.js` to record the demo with narration, mixing audio and video frames into an MP4 format.
    - Added `video_server.py` to serve the demo and handle video uploads, saving the recorded MP4 to the specified directory.
    [pivot_assembly_15.stl, pivot_assembly_3.stl, pivot_base.stl, pivot_fit_test.stl, pivot_shell.stl, pivot_washer.stl, ring_mount_pivot.scad, slide_assembly_15.stl]
2026-11-02 Add new STL files and SCAD script for Option 4 Pivot assembly
    - Added assembly_15.stl, assembly_3.stl, base.stl, fit_test.stl, shell.stl, and washer.stl to option4-pivot/stl directory.
    - Introduced option4_pivot.scad script for generating the pivot mount assembly, including detailed comments on functionality and design.
    - Included parameters for print tolerances, angle ranges, and component dimensions to facilitate customization and adjustments.
    [assembly_15.stl, assembly_3.stl, base.stl, block.stl, fit_test.stl, option1_solid.scad, option2_hinge.scad, option3_dovetail.scad]
2026-11-02 Refactor STL and SCAD file paths, add print files for options 1-4, and implement print validation script
    - Updated include paths in option1, option2, option3, and option4 SCAD files to reference mount_common.scad correctly.
    - Modified check_stl.py to point to the new STL file locations.
    - Changed default voice in make_narration.py to "Microsoft David Desktop".
    - Updated pack_demo.py to include new STL files for all options.
    - Revised param_table.py to reflect new model file paths and names.
    - Enhanced record_video.js to display numbered steps in the video overlay.
    - Added render_stl.py usage examples for new STL files.
    - Created print files for each option (1-4) to facilitate specific print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
    [base.scad, block.scad, fit_test.scad, option1_solid.scad, option2_hinge.scad, option3_dovetail.scad, option4_pivot.scad, pin.scad]
2026-11-02 Update print file documentation and validation checks for consistency
    [block.scad]
2026-11-02 Update measurements and add wiring pocket for Option 1 in documentation and code
    [block.scad, block.stl, mount_common.scad, option1_solid.scad]
2026-11-02 Update pocket depth for Option 1 to 20 mm and clarify checks for wiring fit
2026-11-03 Update measurements, add checks, and refine cable funnel design for Option 1
    [block.scad, block.stl, option1_solid.scad]
2026-11-03 Update screw_y parameter description for clarity and context
2026-11-03 Refine cable funnel design and update checks for Option 1; adjust documentation and measurements for accuracy
    [block.scad, block.stl, option1_solid.scad]
2026-11-03 Add 1.5 mm chamfer to cable funnel rim for improved wire fit; update measurements and documentation
    [block.scad, block.stl, option1_solid.scad]
2026-11-03 Enhance cable funnel design with improved centering and updated measurements; refine documentation and STL files
    [block.stl, option1_solid.scad]
2026-11-03 Refine documentation and measurements for cable funnel and mounting block; update STL files for improved accuracy and fit
    [assembly_15.stl, assembly_3.stl, block.scad, block.stl, fit_test.stl, option1_solid.scad, option4_pivot.scad, shell.stl]
2026-11-03 Update documentation and measurements for roof and shell design; enhance STL files for improved fit and functionality
    [assembly_15.stl, assembly_3.stl, base.stl, option4_pivot.scad]
2026-11-03 Enhance labyrinth design for rain resistance; update measurements and STL files for improved accuracy and fit
    [assembly_15.stl, assembly_3.stl, base.stl, fit_test.stl, option2_hinge.scad, option4_pivot.scad, shell.stl]
2026-11-03 Update scene timings and enhance storyboard details for video; adjust durations and add cable funnel description
